EntropicEngineering/hearing_aid/electrical/block_diagram.jpg

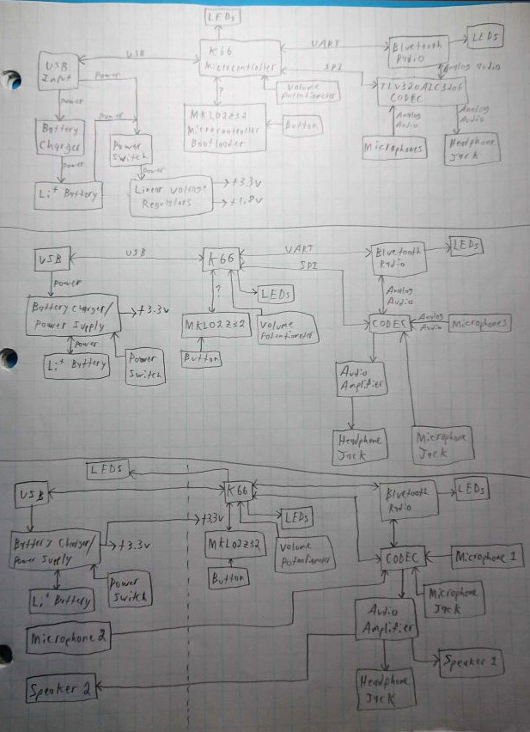
electrical/block_diagram.jpg
