EntropicEngineering/hearing_aid/electrical/k66_pinout.ods

A1 | PTD7 | I/O
A2 | PTD6/LLWU_P15 | I/O
A3 | PTD5 | I/O
A4 | PTD4/LLWU_P14 | I/O
A5 | PTD0/LLWU_P12 | I/O
A6 | PTC16 | I/O
A7 | PTC12 | I/O
A8 | PTC8 | I/O
A9 | PTC4/LLWU_P8 | I/O
A10 | NC | Passive
A11 | PTC3/LLWU_P7 | I/O
A12 | PTC2 | I/O
B1 | PTD12 | I/O
B2 | PTD11/LLWU_P25 | I/O
B3 | PTD10 | I/O
B4 | PTD3 | I/O
B5 | PTC19 | I/O
B6 | PTC15 | I/O
B7 | PTC11/LLWU_P11 | I/O
B8 | PTC7 | I/O
B9 | PTD9 | I/O
B10 | NC | Passive
B11 | PTC1/LLWU_P6 | I/O
B12 | PTC0 | I/O
C1 | PTD15 | I/O
C2 | PTD14 | I/O
C3 | PTD13 | I/O
C4 | PTD2/LLWU_P13 | I/O
C5 | PTC18 | I/O
C6 | PTC14 | I/O
C7 | PTC10 | I/O
C8 | PTC6/LLWU_P10 | I/O
C9 | PTD8/LLWU_P24 | I/O
C10 | NC | Passive
C11 | PTB23 | I/O
C12 | PTB22 | I/O
D1 | PTE2/LLWU_P1 | I/O
D2 | PTE1/LLWU_P0 | I/O
D3 | PTE0 | I/O
D4 | PTD1 | I/O
D5 | PTC17 | I/O
D6 | PTC13 | I/O
D7 | PTC9 | I/O
D8 | PTC5/LLWU_P9 | I/O
D9 | PTB21 | I/O
D10 | PTB20 | I/O
D11 | PTB19 | I/O
D12 | PTB18 | I/O
E1 | PTE6/LLWU_P16 | I/O
E2 | PTE5 | I/O
E3 | PTE4/LLWU_P2 | I/O
E4 | PTE3 | I/O
E5 | VDD | Power
E6 | VDD | Power
E7 | VDD | Power
E8 | VDD | Power
E9 | PTB17 | I/O
E10 | PTB16 | I/O
E11 | PTB11 | I/O
E12 | PTB10 | I/O
F1 | PTE10/LLWU_P18 | I/O
F2 | PTE9/LLWU_P17 | I/O
F3 | PTE8 | I/O
F4 | PTE7 | I/O
F5 | VDD | Power
F6 | VSS | Power
F7 | VSS | Power
F8 | VDD | Power
F9 | PTB9 | I/O
F10 | PTB8 | I/O
F11 | PTB7 | I/O
F12 | PTB6 | I/O
G1 | VREG_OUT | Power
G2 | VREG_IN0 | Power
G3 | PTE12 | I/O
G4 | PTE11 | I/O
G5 | VREFH | Power
G6 | VREFL | Power
G7 | VSS | Power
G8 | VSS | Power
G9 | PTB5 | I/O
G10 | PTB4 | I/O
G11 | PTB3 | I/O
G12 | PTB2 | I/O
H1 | USB0_DP | I/O
H2 | USB0_DM | I/O
H3 | VSS | Power
H4 | PTE28 | I/O
H5 | VDDA | Power
H6 | VSSA | Power
H7 | VSS | Power
H8 | VSS | Power
H9 | PTB1 | I/O
H10 | PTB0/LLWU_P5 | I/O
H11 | PTBA29 | I/O
H12 | PTA28 | I/O
J1 | USB1_DP | I/O
J2 | VREG_IN1 | Power
J3 | ADC0_SE16/CMP1_IN2/ADC0_SE21 | I/O
J4 | PTE27 | I/O
J5 | PTA0 | I/O
J6 | PTA1 | I/O
J7 | PTA6 | I/O
J8 | PTA7 | I/O
J9 | PTA13/LLWU_P4 | I/O
J10 | PTA27 | I/O
J11 | PTA26 | I/O
J12 | PTA25 | I/O
K1 | USB1_DM | I/O
K2 | USB1_VSS | Power
K3 | ADC1_SE16/CMP2_IN2/ADC0_SE22 | Input
K4 | PTE26 | I/O
K5 | PTE25/LLWU_P21 | I/O
K6 | PTA2 | I/O
K7 | PTA3 | I/O
K8 | PTA8 | I/O
K9 | PTA12 | I/O
K10 | PTA16 | I/O
K11 | PTA17 | I/O
K12 | PTA24 | I/O
L1 | USB1_VBUS | Power
L2 | ADC0_DM0/ADC1_DM3 | Input
L3 | DAC0_OUT/CMP1_IN3/ADC0_SE23 | I/O
L4 | DAC1_OUT/CMP0_IN4/CMP2_IN3/ADC1_SE23 | I/O
L5 | RTC_WAKEUP_B | Input
L6 | VBAT | Power
L7 | PTA4/LLWU_P3 | I/O
L8 | PTA9 | I/O
L9 | PTA11/LLWU_P23 | I/O
L10 | PTA14 | I/O
L11 | PTA15 | I/O
L12 | RESET_b | Input
M1 | ADC1_DP0/ADC0_DP3 | Input
M2 | ADC1_DM0/ADC0_DM3 | Input
M3 | VREF_OUT/CMP1_IN5/CMP0_IN5/ADC1_SE18 | I/O
M4 | PTE24 | I/O
M5 | NC | Passive
M6 | EXTAL32 | I/O
M7 | XTAL32 | I/O
M8 | PTA5 | I/O
M9 | PTA10/LLWU_P22 | I/O
M10 | VSS | Power
M11 | PTA19 | I/O
M12 | PTA18 | I/O
