EntropicEngineering/hearing_aid/electrical/models/spm0687lr5h-1.step

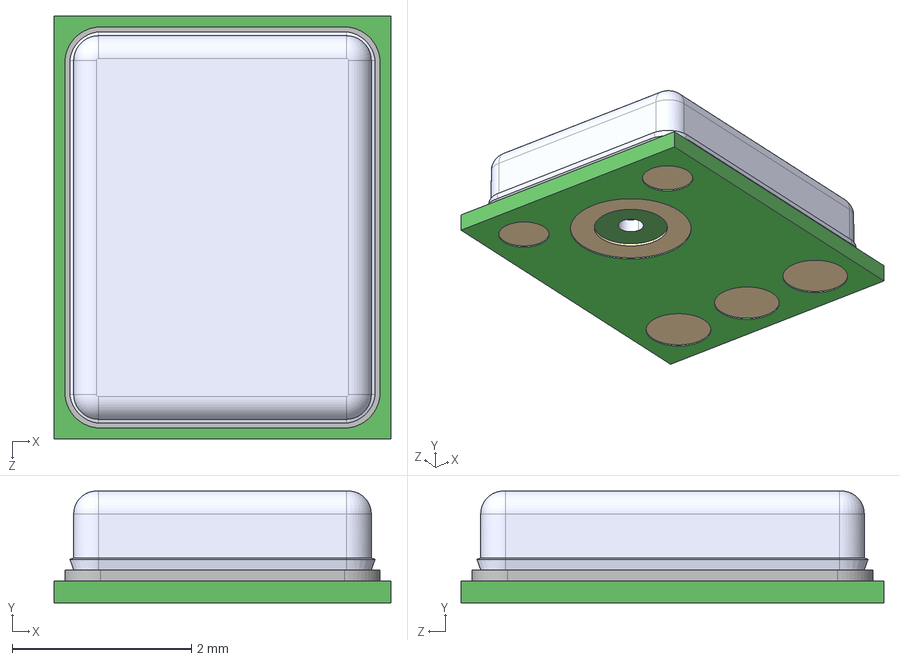
[picture p2: CAD file, 2021-08-15]
electrical/models/spm0687lr5h-1.step
3.76 x 1.25 x 4.72 mm
