EntropicEngineering/hearing_aid/electrical/models/ptr901-2015k-b502_potentiometer.step

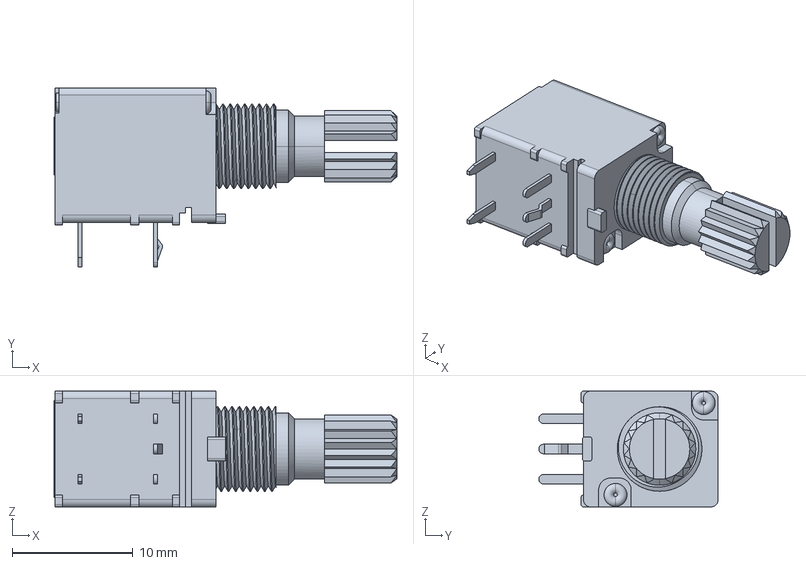
[picture p3: CAD file, 2021-08-15]
electrical/models/ptr901-2015k-b502_potentiometer.step
28.4 x 14.9 x 9.60 mm
