EntropicEngineering/hearing_aid/electrical/models/rv121sf-30-009j-b5k-00k_potentiometer.sldprt

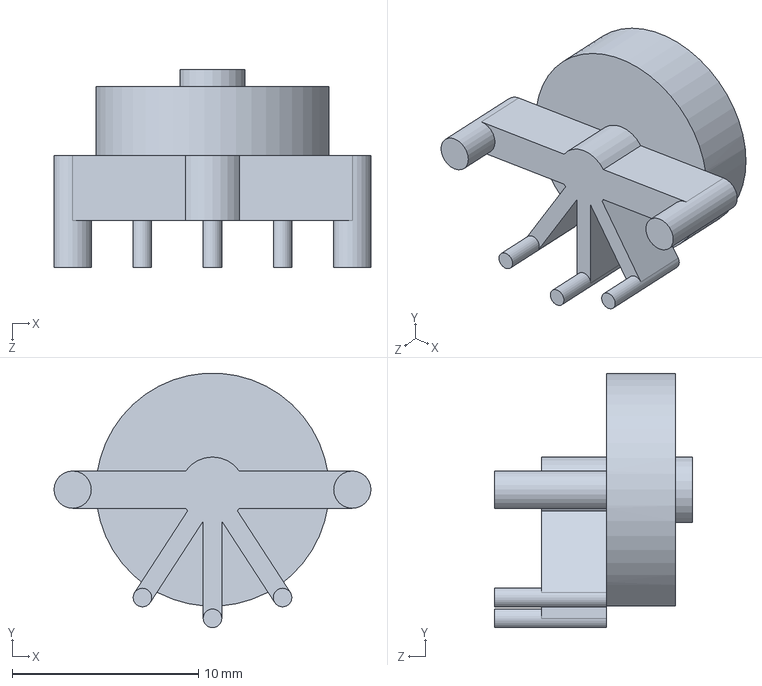
[picture p4: CAD file, 2021-08-15]
electrical/models/rv121sf-30-009j-b5k-00k_potentiometer.sldprt
17.0 x 13.6 x 10.6 mm
