EntropicEngineering/hearing_aid/electrical/models/BC127v4x_3.step

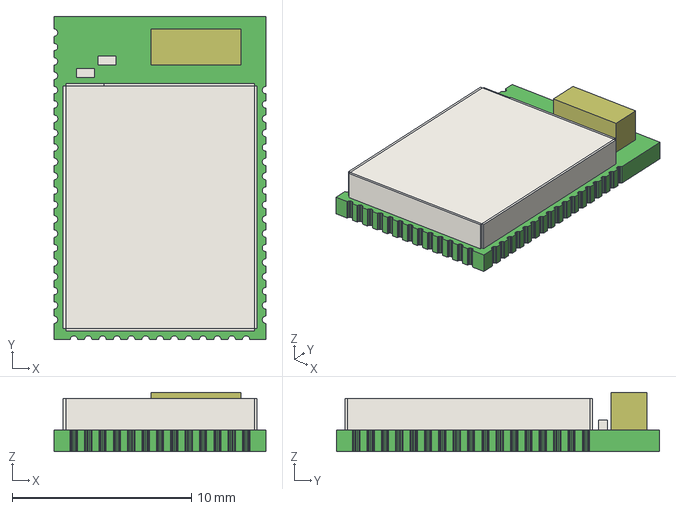
[picture p5: CAD file, 2021-08-15]
electrical/models/BC127v4x_3.step
11.8 x 18.0 x 3.30 mm
Board
Extruded x 29
