EntropicEngineering/hearing_aid/(list of files, cad)

Other CAD files:
electrical/models/ptr901-2015k-b502_potentiometer.sldprt
