EntropicEngineering/hearing_aid/old_version/Tympan-Nya-schematic.pdf

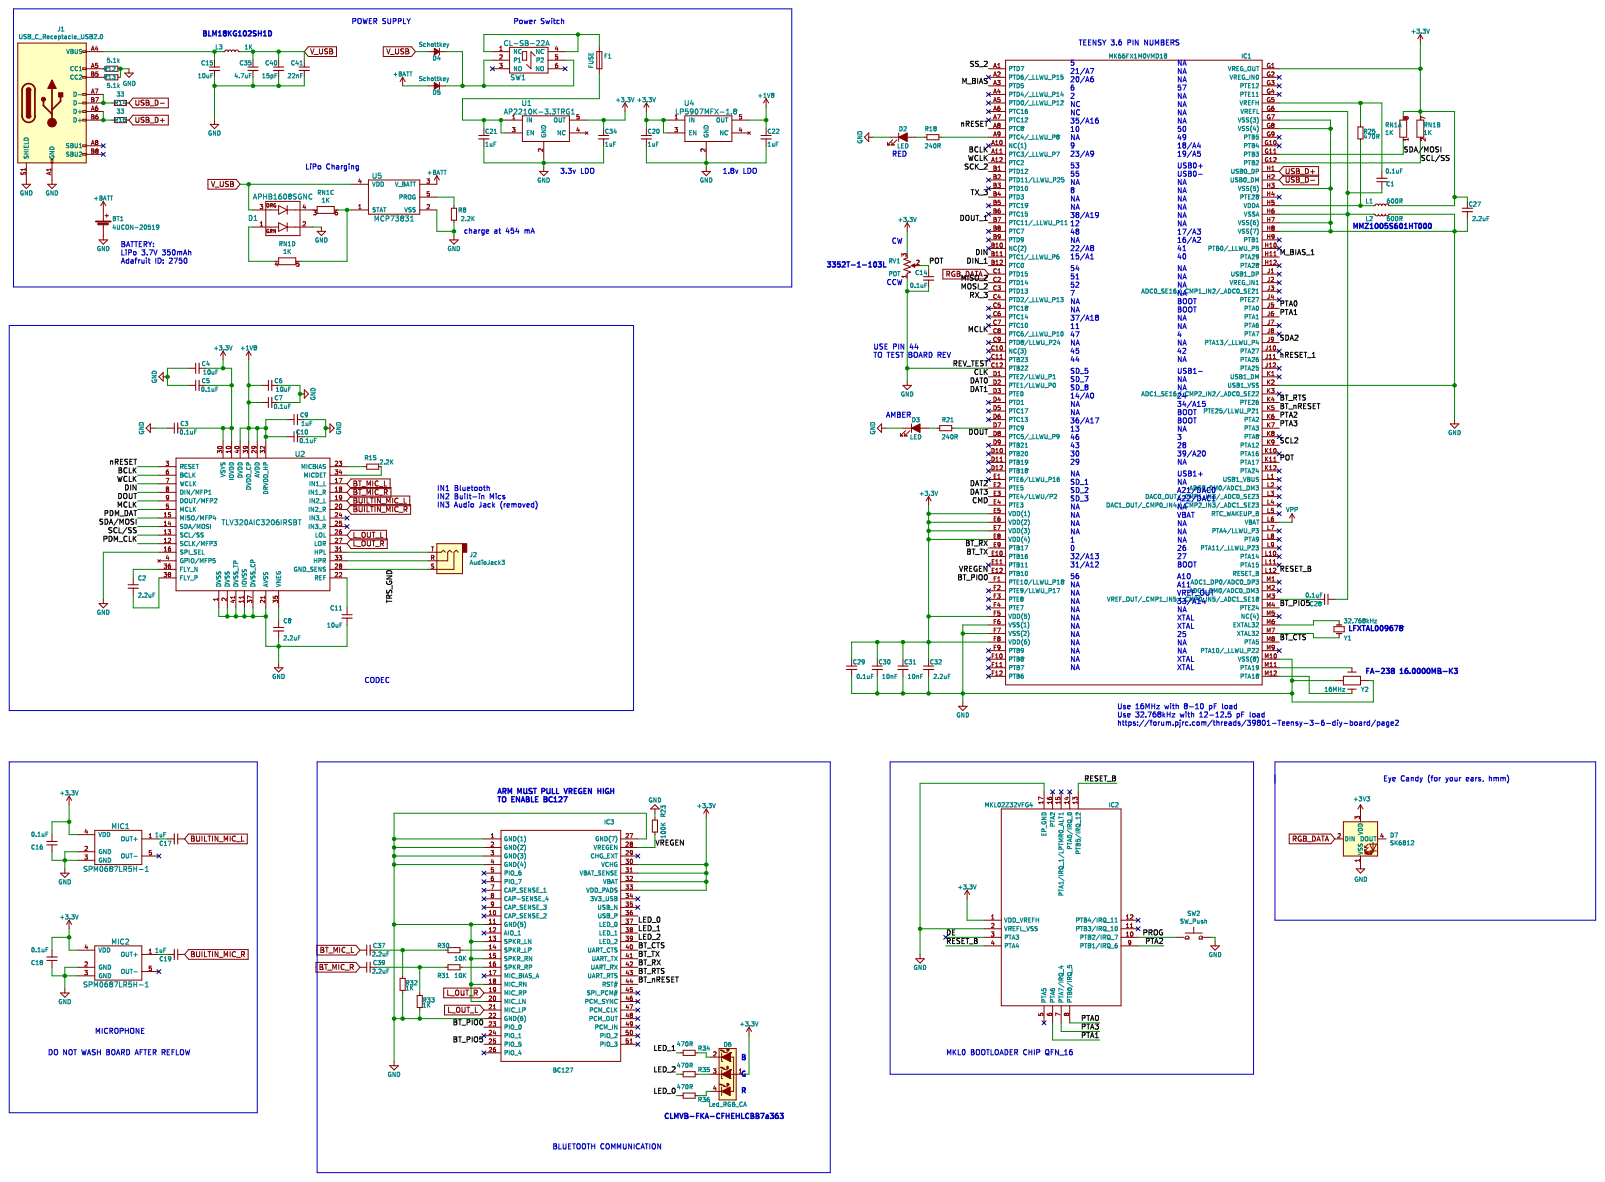
[picture p6: page 1]
