EntropicEngineering/hearing_aid/(list of files, drawings)

Other design files:
electrical/audio.SchDoc
electrical/digital.SchDoc
electrical/hearing_aid.PcbLib
electrical/hearing_aid.PrjPcb
electrical/hearing_aid.SchLib
electrical/power.SchDoc
