EntropicEngineering/hearing_aid/old_version/Tympan-Nya.kicad_pcb

## KiCad design old_version/Tympan-Nya.kicad_pcb (2021-06-19, an earlier design)

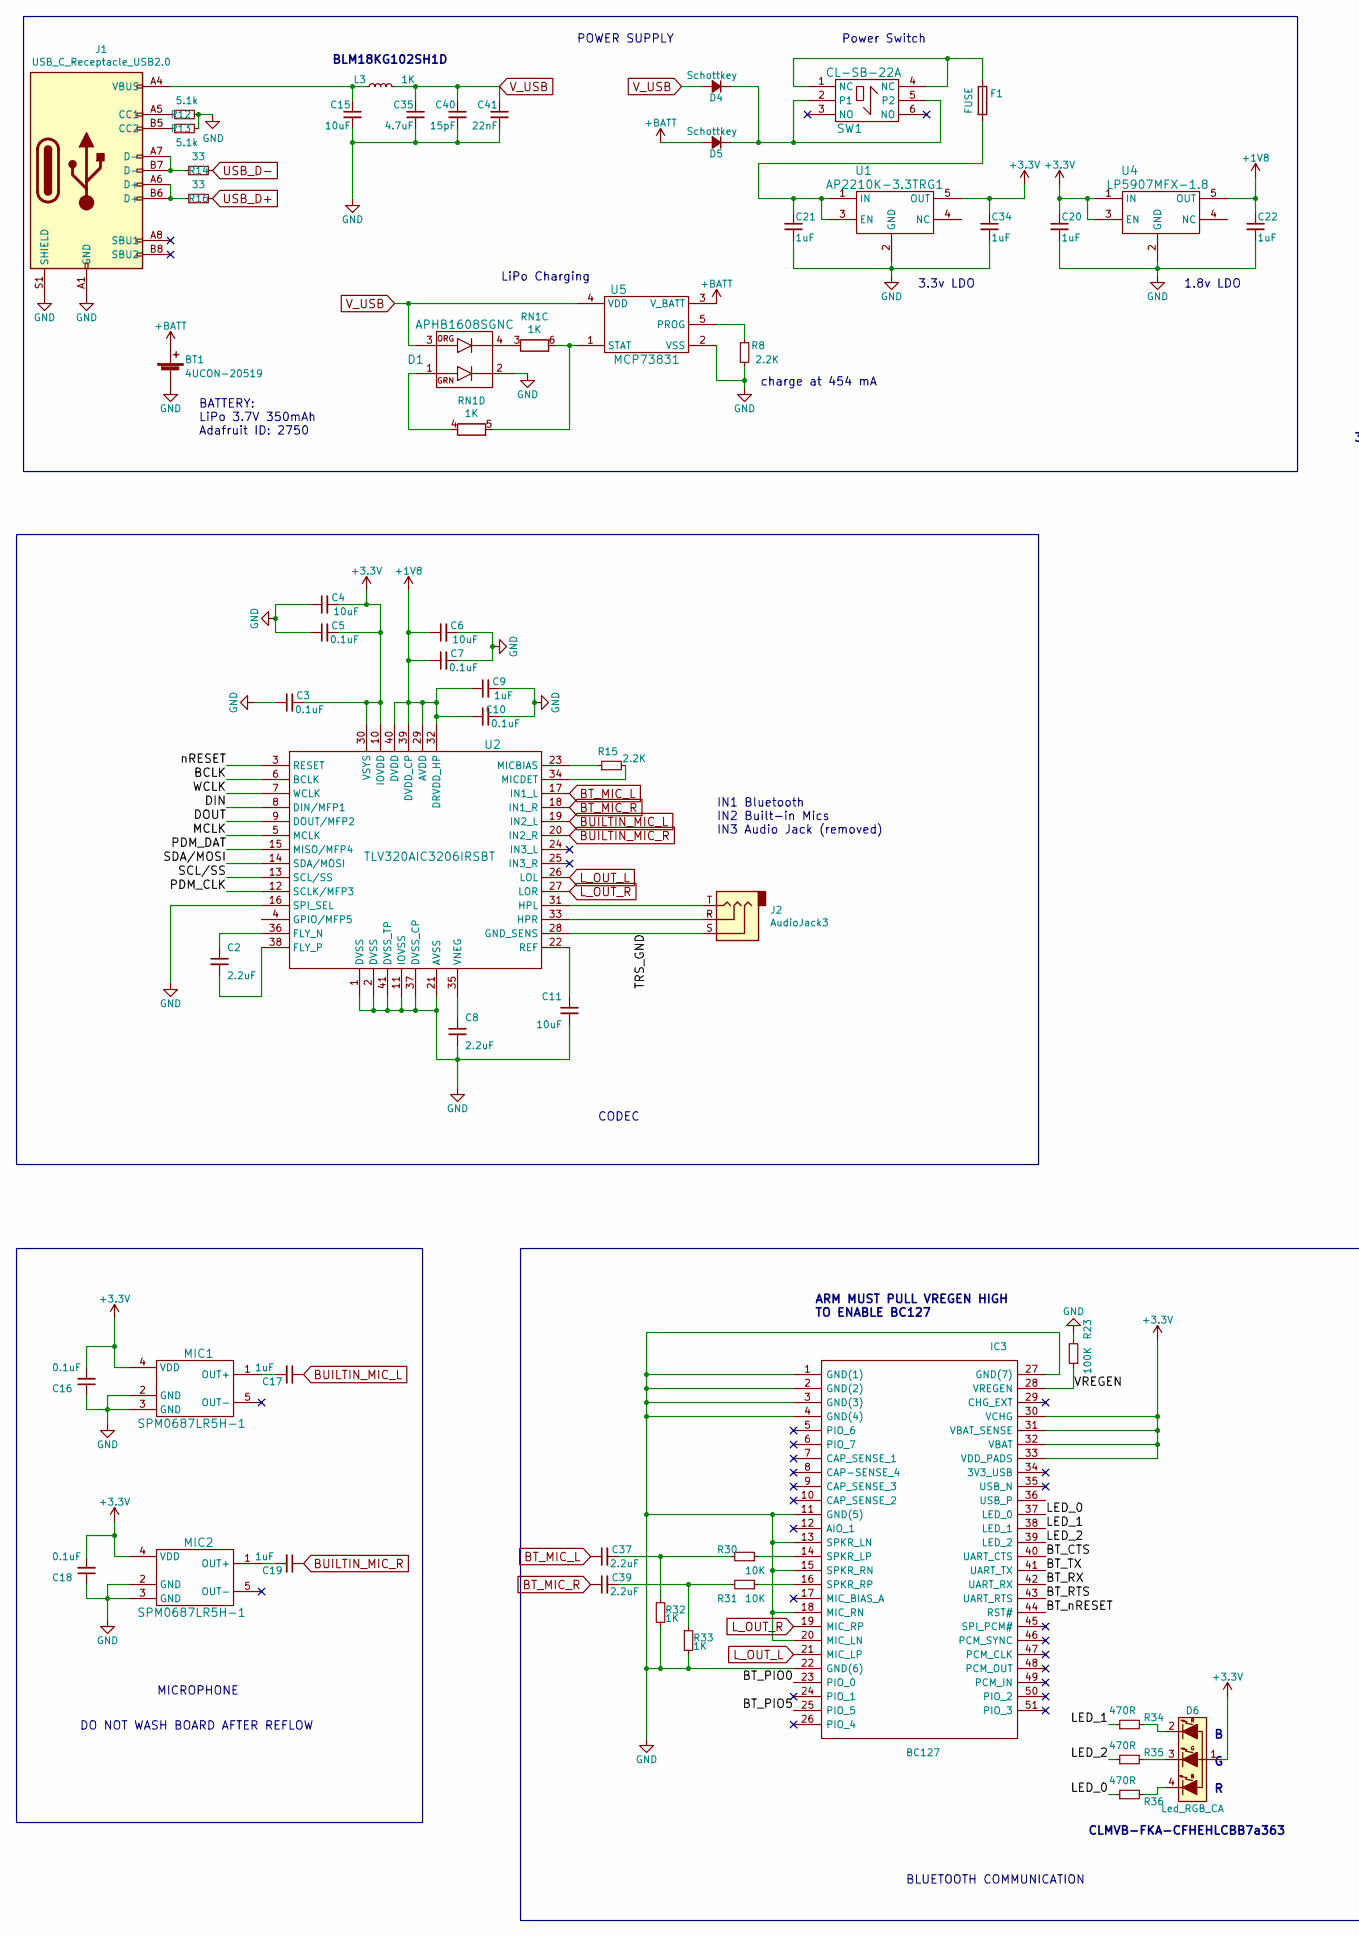
[picture p7: schematic Tympan-Nya.kicad_sch, Tympan Rev D 3, part in row 1, column 1]

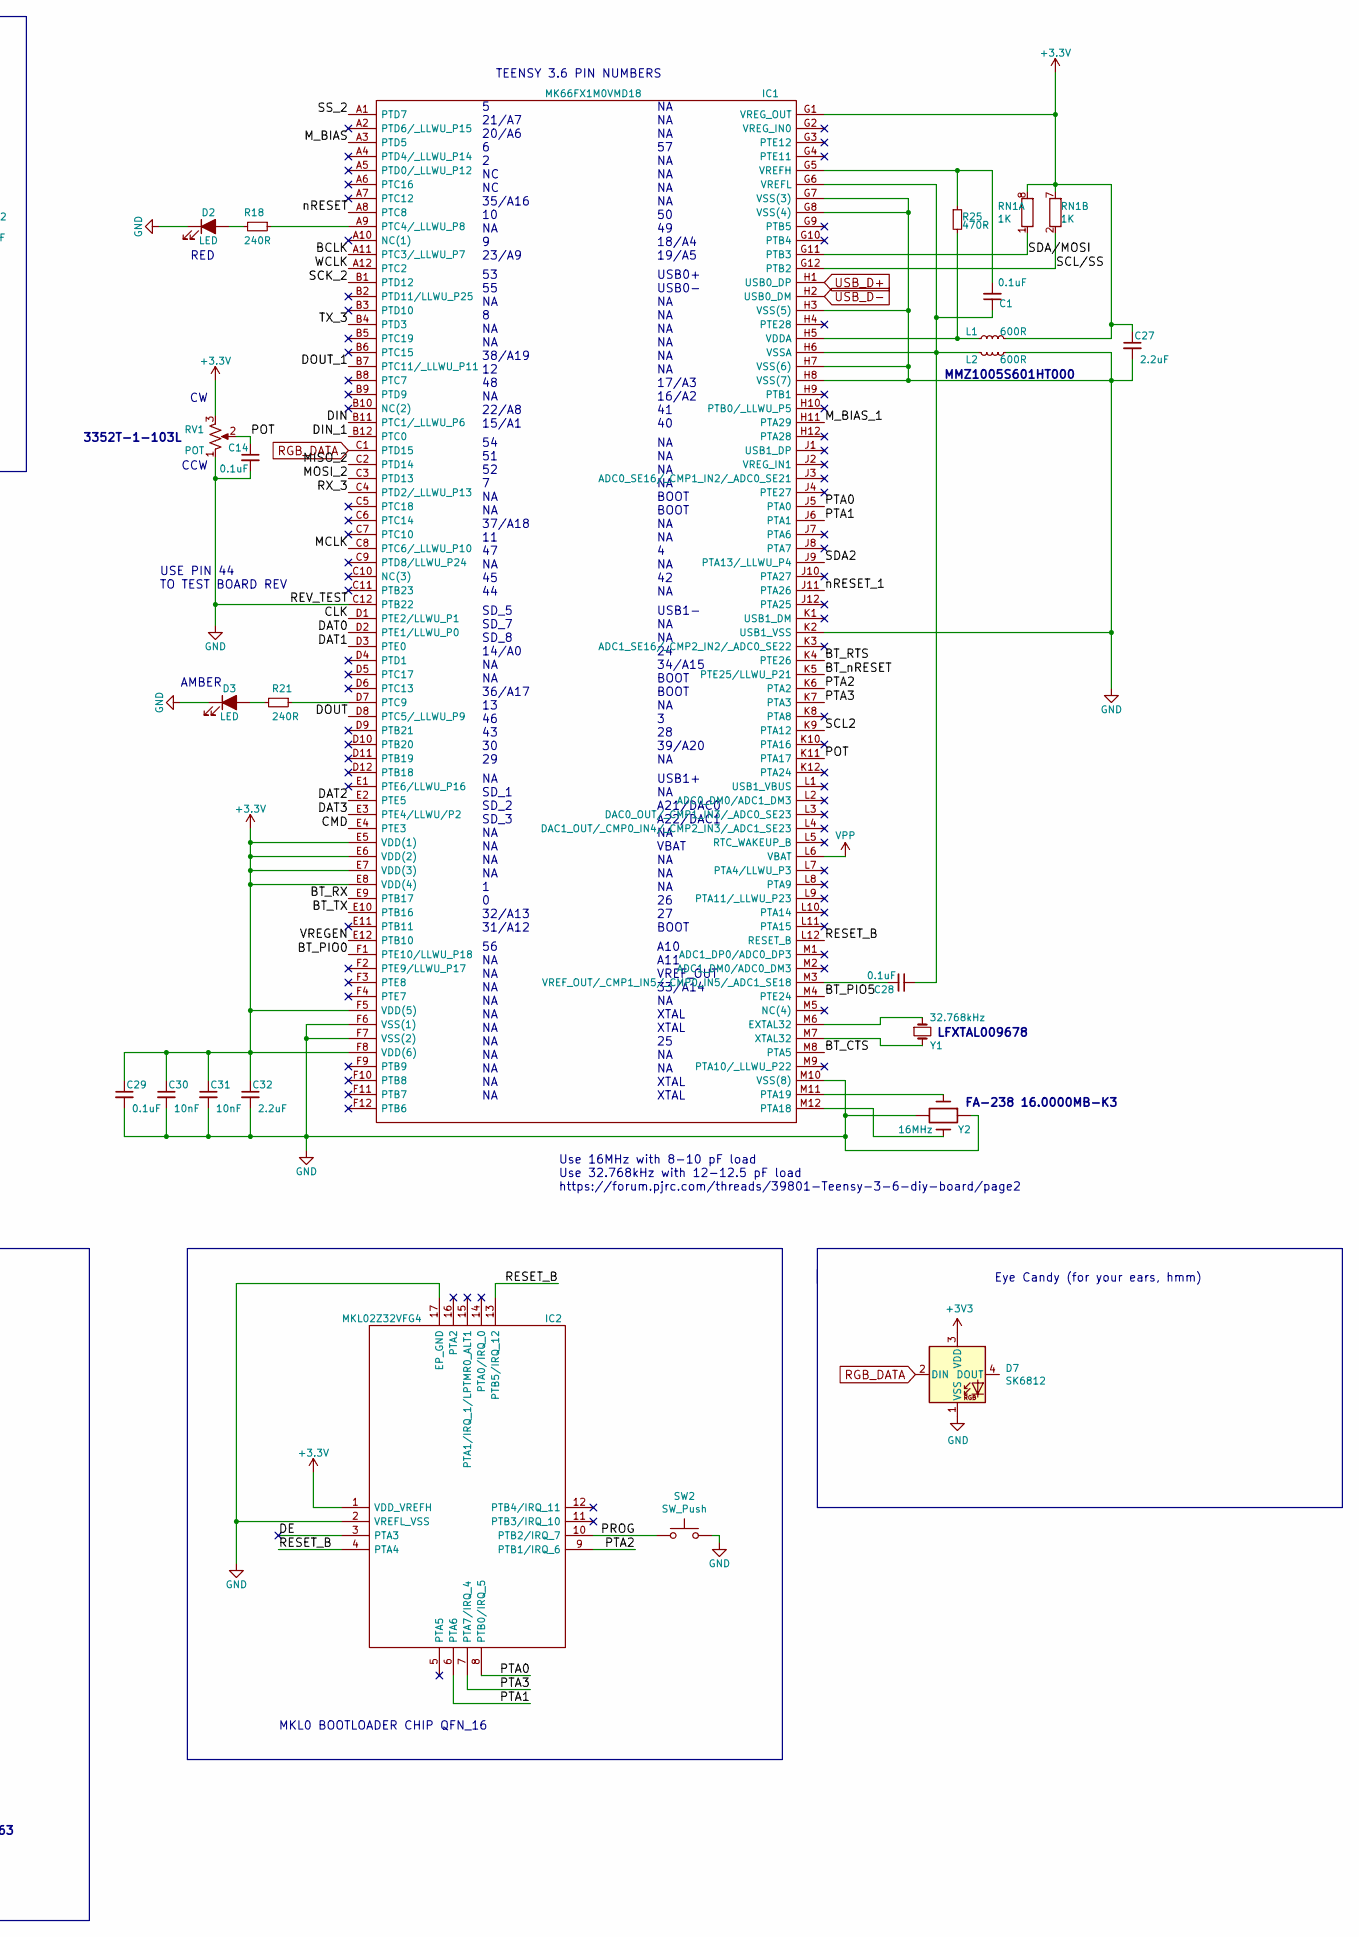
[picture p8: schematic Tympan-Nya.kicad_sch, Tympan Rev D 3, part in row 1, column 2]

Parts:
BT1: 4UCON-20519; 4UCON-0217-20519
C1, C3, C5, C7, C10, C14, C16, C18, C28, C29: 0.1uF; C_0402_1005Metric
C2, C8, C27, C32, C37, C39: 2.2uF; C_0402_1005Metric
C4, C6, C11, C15: 10uF; C_0402_1005Metric
C9, C17, C19, C20, C21, C22, C34: 1uF; C_0402_1005Metric
C30, C31: 10nF; C_0402_1005Metric
C35: 4.7uF; C_0402_1005Metric
C40: 15pF; C_0402_1005Metric
C41: 22nF; C_0402_1005Metric
D1: APHB1608SGNC; ABHB1608S
D2, D3: LED; LED_0805_2012Metric
D4, D5: Schottkey; ACDBA340-HF
D6: Led_RGB_CA; CLMVB-FKA-CFHEHLCBB7a363
D7: SK6812; LED_SK6812_PLCC4_5.0x5.0mm_P3.2mm
F1: FUSE; Fuse_1206_3216Metric
IC1: MK66FX1M0VMD18; BGA-144_13.0x13.0mm_Layout12x12_P1.0mm; Manufacturer_Part_Number MK66FX1M0VMD18
IC2: MKL02Z32VFG4; QFN-16-1EP_3x3mm_P0.5mm_EP1.7x1.7mm; Manufacturer_Part_Number MKL02Z32VFG4
IC3: BC127; Manufacturer_Part_Number bc127
J1: USB_C_Receptacle_USB2.0; USB_C_Receptacle_HRO_TYPE-C-31-M-12
J2: AudioJack3; Jack_3.5mm_CUI_SJ-3523-SMT_Horizontal; DigiKey SJ-2523-SMT-TR
L1, L2: 600R; L_0402_1005Metric
L3: 1K; L_0603_1608Metric
MIC1, MIC2: SPM0687LR5H-1
R8, R15: 2.2K; R_0402_1005Metric
R12, R13: 5.1k; R_0402_1005Metric
R14, R16: 33; R_0402_1005Metric
R18, R21: 240R; R_0402_1005Metric
R23: 100K; R_0402_1005Metric
R25, R34, R35, R36: 470R; R_0402_1005Metric
R30, R31: 10K; R_0402_1005Metric
R32, R33: 1K; R_0402_1005Metric
RN1: 1K; R_Array_Convex_4x0603
RV1: POT; PinHeader_1x03_P2.54mm_Vertical
SW1: CL-SB-22A
SW2: SW_Push; SW_SPST_TL3342
U1: AP2210K-3.3TRG1; SOT-23-5
U2: TLV320AIC3206IRSBT; UQFN-40-1EP_5x5mm_P0.4mm_EP3.8x3.8mm
U4: LP5907MFX-1.8; SOT-23-5
U5: MCP73831; SOT-23-5
Y1: 32.768kHz; LFXTAL009678
Y2: 16MHz; FA_238_16.0000MB_K3

Connections:
+1V8: C6.1, C7.1, C9.1, C10.1, C22.1, U2.29 (AVDD), U2.32 (DRVDD_HP), U2.39 (DVDD_CP), U2.40 (DVDD), U4.5 (OUT)
+BATT: BT1.1 (+), D5.2 (A), U5.3 (V_BATT)
/BCLK: IC1.A11 (PTC3/_LLWU_P7), U2.6 (BCLK)
/BT_CTS: IC1.M8 (PTA5), IC3.40 (UART_CTS)
/BT_PIO0: IC1.F1 (PTE10/LLWU_P18), IC3.23 (PIO_0)
/BT_PIO5: IC1.M4 (PTE24), IC3.25 (PIO_5)
/BT_RTS: IC1.K4 (PTE26), IC3.43 (UART_RTS)
/BT_RX: IC1.E9 (PTB17), IC3.42 (UART_RX)
/BT_TX: IC1.E10 (PTB16), IC3.41 (UART_TX)
/BT_nRESET: IC1.K5 (PTE25/LLWU_P21), IC3.44 (RST#)
/CLK: IC1.D1 (PTE2/LLWU_P1)
/CMD: IC1.E4 (PTE3)
/DAT0: IC1.D2 (PTE1/LLWU_P0)
/DAT1: IC1.D3 (PTE0)
/DAT2: IC1.E2 (PTE5)
/DAT3: IC1.E3 (PTE4/LLWU/P2)
/DE: IC2.3 (PTA3)
/DIN: IC1.B11 (PTC1/_LLWU_P6), U2.8 (DIN/MFP1)
/DIN_1: IC1.B12 (PTC0)
/DOUT: IC1.D8 (PTC5/_LLWU_P9), U2.9 (DOUT/MFP2)
/DOUT_1: IC1.B7 (PTC11/_LLWU_P11)
/LED_0: IC3.37 (LED_0), R36.1
/LED_1: IC3.38 (LED_1), R34.1
/LED_2: IC3.39 (LED_2), R35.1
/MCLK: IC1.C8 (PTC6/_LLWU_P10), U2.5 (MCLK)
/MISO_2: IC1.C2 (PTD14)
/MOSI_2: IC1.C3 (PTD13)
/M_BIAS: IC1.A3 (PTD5)
/M_BIAS_1: IC1.H11 (PTA29)
/PDM_CLK: U2.12 (SCLK/MFP3)
/PDM_DAT: U2.15 (MISO/MFP4)
/POT: C14.1, IC1.K11 (PTA17), RV1.2
/PROG: IC2.10 (PTB2/IRQ_7), SW2.1
/PTA0: IC1.J5 (PTA0), IC2.8 (PTB0/IRQ_5)
/PTA1: IC1.J6 (PTA1), IC2.6 (PTA6)
/PTA2: IC1.K6 (PTA2), IC2.9 (PTB1/IRQ_6)
/PTA3: IC1.K7 (PTA3), IC2.7 (PTA7/IRQ_4)
/RESET_B: IC1.L12 (RESET_B), IC2.4 (PTA4), IC2.13 (PTB5/IRQ_12)
/RX_3: IC1.C4 (PTD2/_LLWU_P13)
/SCK_2: IC1.B1 (PTD12)
/SCL2: IC1.K9 (PTA12)
/SCL/SS: IC1.G12 (PTB2), RN1.2 (R2.1), U2.13 (SCL/SS)
/SDA2: IC1.J9 (PTA13/_LLWU_P4)
/SDA/MOSI: IC1.G11 (PTB3), RN1.1 (R1.1), U2.14 (SDA/MOSI)
/SS_2: IC1.A1 (PTD7)
/TRS_GND: J2.S, U2.28 (GND_SENS)
/TX_3: IC1.B4 (PTD3)
/VREGEN: IC1.E12 (PTB10), IC3.28 (VREGEN), R23.1
/WCLK: IC1.A12 (PTC2), U2.7 (WCLK)
/nRESET: IC1.A8 (PTC8), U2.3 (RESET)
/nRESET_1: IC1.J11 (PTA26)
BT_MIC_L: C37.1, U2.17 (IN1_L)
BT_MIC_R: C39.1, U2.18 (IN1_R)
BUILTIN_MIC_L: C17.1, U2.19 (IN2_L)
BUILTIN_MIC_R: C19.1, U2.20 (IN2_R)
GND: BT1.2 (-), C3.1, C4.1, C5.1, C6.2, C7.2, C8.2, C9.2, C10.2, C11.2, C14.2, C15.2, C16.1, C18.1, C20.2, C21.2, C22.2, C27.2, C29.2, C30.2, C31.2, C32.2, C34.2, C35.2, C40.2, C41.2, D1.2, D2.1 (K), D3.1 (K), D7.1 (VSS), IC1.C12 (PTB22), IC1.F6 (VSS(1)), IC1.F7 (VSS(2)), IC1.G7 (VSS(3)), IC1.G8 (VSS(4)), IC1.H3 (VSS(5)), IC1.H7 (VSS(6)), IC1.H8 (VSS(7)), IC1.K2 (USB1_VSS), IC1.M10 (VSS(8)), IC2.2 (VREFL_VSS), IC2.17 (EP_GND), IC3.1 (GND(1)), IC3.2 (GND(2)), IC3.3 (GND(3)), IC3.4 (GND(4)), IC3.11 (GND(5)), IC3.13 (SPKR_LN), IC3.15 (SPKR_RN), IC3.18 (MIC_RN), IC3.20 (MIC_LN), IC3.22 (GND(6)), IC3.27 (GND(7)), J1.A1 (GND), J1.A12 (GND), J1.B1 (GND), J1.B12 (GND), J1.S1 (SHIELD), L2.2, MIC1.2 (GND), MIC1.3 (GND), MIC2.2 (GND), MIC2.3 (GND), R8.2, R12.2, R13.2, R23.2, R32.2, R33.2, RV1.1, SW2.2, U1.2 (GND), U2.1 (DVSS), U2.2 (DVSS), U2.11 (IOVSS), U2.16 (SPI_SEL), U2.21 (AVSS), U2.37 (DVSS_CP), U2.41 (DVSS_TP), U4.2 (GND), U5.2 (VSS), Y2.2, Y2.4
L_OUT_L: IC3.21 (MIC_LP), U2.26 (LOL)
L_OUT_R: IC3.19 (MIC_RP), U2.27 (LOR)
unnamed: C1.1, C28.1, IC1.G6 (VREFL), IC1.H6 (VSSA), L2.1
unnamed: C1.2, IC1.G5 (VREFH), R25.1
unnamed: C2.1, U2.36 (FLY_N)
unnamed: C2.2, U2.38 (FLY_P)
unnamed: C8.1, U2.35 (VNEG)
unnamed: C11.1, U2.22 (REF)
unnamed: C15.1, J1.A4 (VBUS), J1.A9 (VBUS), J1.B4 (VBUS), J1.B9 (VBUS), L3.1
unnamed: C17.2, MIC1.1 (OUT+)
unnamed: C19.2, MIC2.1 (OUT+)
unnamed: C21.1, F1.2, U1.1 (IN), U1.3 (EN)
unnamed: C28.2, IC1.M3 (VREF_OUT/_CMP1_IN5/_CMP0_IN5/_ADC1_SE18)
unnamed: C37.2, R30.2, R32.1
unnamed: C39.2, R31.2, R33.1
unnamed: D1.1, RN1.4 (R4.1)
unnamed: D1.4, RN1.3 (R3.1)
unnamed: D2.2 (A), R18.2
unnamed: D3.2 (A), R21.2
unnamed: D4.1 (K), D5.1 (K), SW1.2 (P1), SW1.5 (P2)
unnamed: D6.2 (R), R34.2
unnamed: D6.3 (G), R35.2
unnamed: D6.4 (B), R36.2
unnamed: F1.1, SW1.1 (NC), SW1.4 (NC)
unnamed: IC1.A9 (PTC4/_LLWU_P8), R18.1
unnamed: IC1.D7 (PTC9), R21.1
unnamed: IC1.H5 (VDDA), L1.1, R25.2
unnamed: IC1.M6 (EXTAL32), Y1.1
unnamed: IC1.M7 (XTAL32), Y1.2
unnamed: IC1.M11 (PTA19), Y2.1
unnamed: IC1.M12 (PTA18), Y2.3
unnamed: IC3.14 (SPKR_LP), R30.1
unnamed: IC3.16 (SPKR_RP), R31.1
unnamed: J1.A5 (CC1), R12.1
unnamed: J1.A6 (D+), J1.B6 (D+), R16.1
unnamed: J1.A7 (D-), J1.B7 (D-), R14.1
unnamed: J1.B5 (CC2), R13.1
unnamed: J2.R, U2.33 (HPR)
unnamed: J2.T, U2.31 (HPL)
unnamed: R8.1, U5.5 (PROG)
unnamed: R15.1, U2.23 (MICBIAS)
unnamed: R15.2, U2.34 (MICDET)
unnamed: RN1.5 (R4.2), RN1.6 (R3.2), U5.1 (STAT)
RGB_DATA: D7.2 (DIN), IC1.C1 (PTD15)
USB_D+: IC1.H1 (USB0_DP), R16.2
USB_D-: IC1.H2 (USB0_DM), R14.2
VPP: IC1.L6 (VBAT)
V_USB: C35.1, C40.1, C41.1, D1.3, D4.2 (A), L3.2, U5.4 (VDD)

Notes on the sheet:
DO NOT WASH BOARD AFTER REFLOW
MICROPHONE
BATTERY: LiPo 3.7V 350mAh Adafruit ID: 2750
BLM18KG102SH1D
POWER SUPPLY
LiPo Charging
CODEC
IN1 Bluetooth IN2 Built-in Mics IN3 Audio Jack (removed)
ARM MUST PULL VREGEN HIGH TO ENABLE BC127
charge at 454 mA
BLUETOOTH COMMUNICATION
Power Switch
3.3v LDO
CLMVB-FKA-CFHEHLCBB7a363
B G R
1.8v LDO
3352T-1-103L
USE PIN 44 TO TEST BOARD REV
CW CCW
RED
AMBER
MKL0 BOOTLOADER CHIP QFN_16
5 21/A7 20/A6 6 2 NC NC 35/A16 10 NA 9 23/A9
53 55 NA 8 NA NA 38/A19 12 48 NA 22/A8 15/A1
54 51 52 7 NA NA 37/A18 11 47 NA 45 44
SD_5 SD_7 SD_8 14/A0 NA NA 36/A17 13 46 43 30 29
NA SD_1 SD_2 SD_3 NA NA NA NA 1 0 32/A13 31/A12
56 NA NA NA NA NA NA NA NA NA NA NA
TEENSY 3.6 PIN NUMBERS
Use 16MHz with 8-10 pF load Use 32.768kHz with 12-12.5 pF load https://forum.pjrc.com/threads/39801-Teensy-3-6-diy-board/page2
NA NA NA 57 NA NA NA NA 50 49 18/A4 19/A5
USB0+ USB0- NA NA NA NA NA NA 17/A3 16/A2 41 40
NA NA NA NA BOOT BOOT NA NA 4 NA 42 NA
USB1- NA NA 24 34/A15 BOOT BOOT NA 3 28 39/A20 NA
USB1+ NA A21/DAC0 A22/DAC1 NA VBAT NA NA NA 26 27 BOOT
A10 A11 VREF_OUT 33/A14 NA XTAL XTAL 25 NA NA XTAL XTAL
LFXTAL009678
MMZ1005S601HT000
FA-238 16.0000MB-K3
Eye Candy (for your ears, hmm)

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
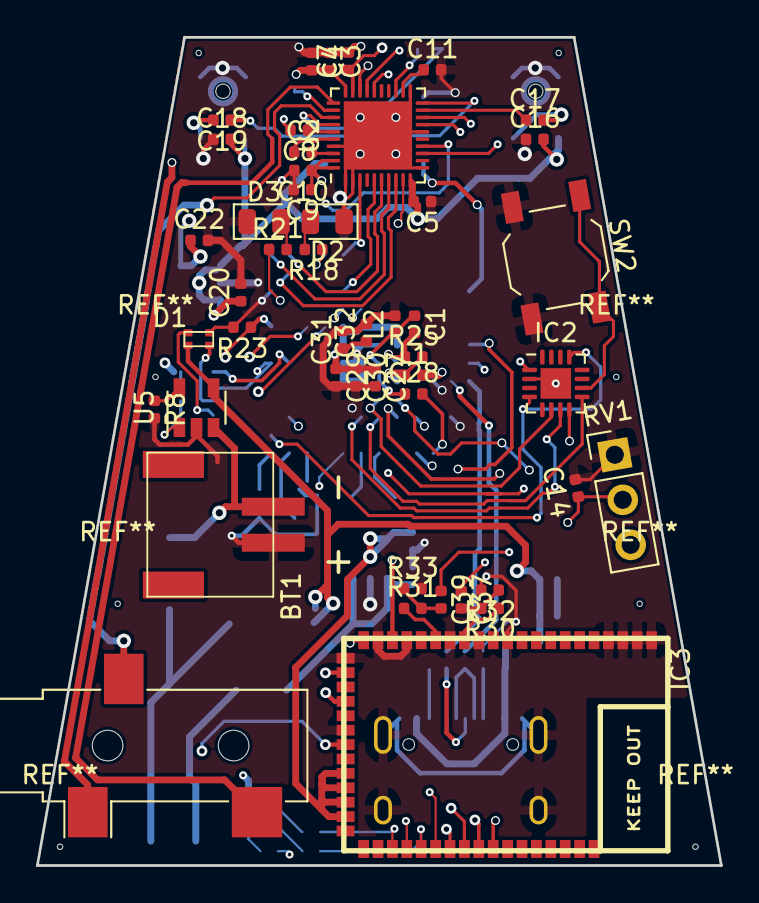
[picture p9: board Tympan-Nya.kicad_pcb from above]

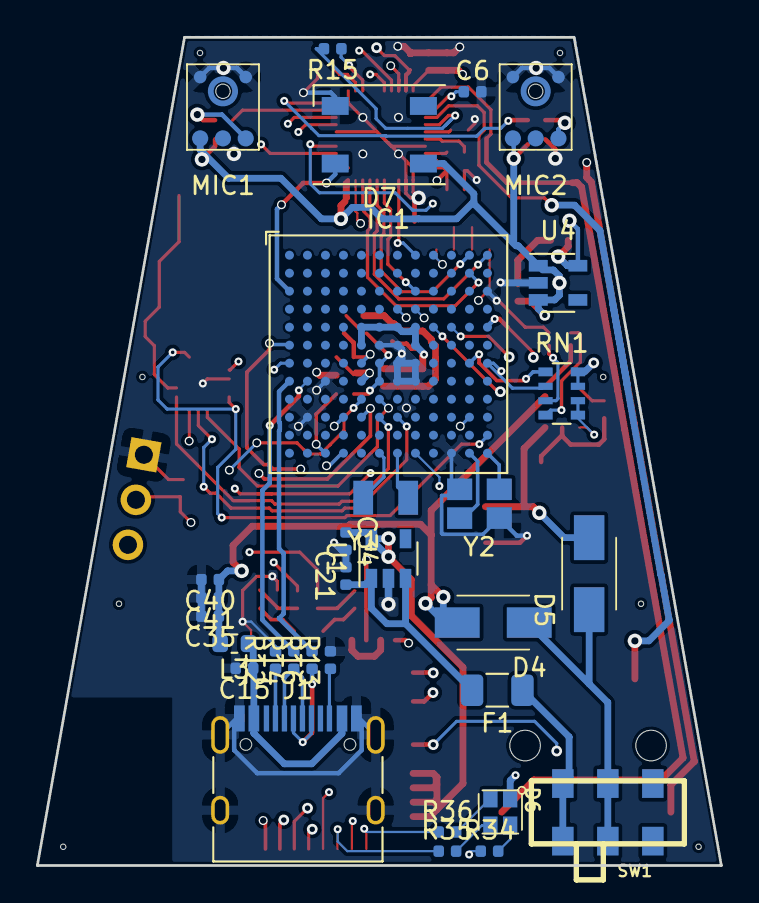
[picture p10: board Tympan-Nya.kicad_pcb from below]

Board: 4 copper layers, 38.0 x 46.0 mm, 78 parts (31 on the bottom side), 82 nets.
