EntropicEngineering/hearing_aid/(commit log)

2021-06-19 Initial commit.
    [Tympan-Nya-B_Adhes.gbr, Tympan-Nya-B_CrtYd.gbr, Tympan-Nya-B_Cu.gbr, Tympan-Nya-B_Mask.gbr, Tympan-Nya-B_Paste.gbr, Tympan-Nya-B_SilkS.gbr, Tympan-Nya-Cmts_User.gbr, Tympan-Nya-Dwgs_User.gbr]
2021-08-15 Added many files.
    [BC127v4x_3.step, audio.SchDoc, digital.SchDoc, hearing_aid.PcbLib, hearing_aid.PrjPcb, hearing_aid.SchLib, k66_pinout.ods, power.SchDoc]
2021-08-16 Simplify USB Type-C
    [hearing_aid.SchLib, power.SchDoc]
2021-08-16 LiPo charging schematic
    [hearing_aid.SchLib, power.SchDoc]
2021-08-16 revert USB-C connector, use consistent symbols
    [hearing_aid.SchLib, power.SchDoc]
